hadongz/CFBoard/CFBoard.kicad_pcb

## KiCad design CFBoard.kicad_pcb (2025-09-06)

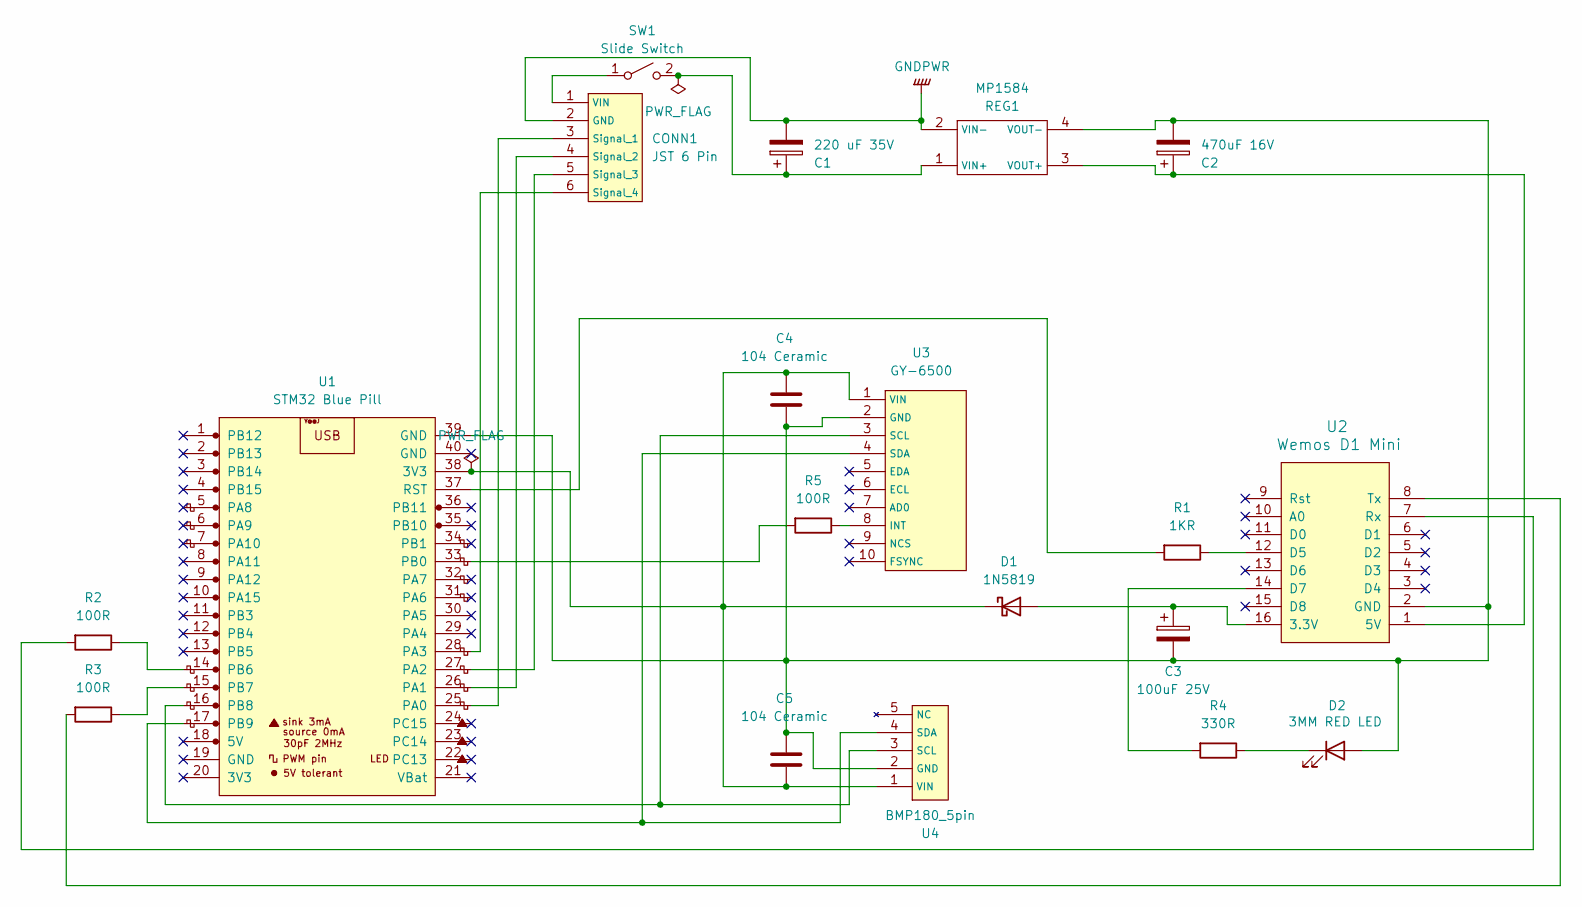
[picture p1: schematic CFBoard.kicad_sch]

Parts:
C1: 220 uF 35V; CP_Radial_D6.3mm_P2.50mm
C2: 470uF 16V; CP_Radial_D5.0mm_P2.50mm
C3: 100uF 25V; CP_Radial_D5.0mm_P2.50mm
C4, C5: 104 Ceramic; C_Disc_D4.3mm_W1.9mm_P5.00mm
CONN1: JST 6 Pin; JST_XH_B6B-XH-A_1x06_P2.50mm_Vertical
D1: 1N5819; D_DO-41_SOD81_P10.16mm_Horizontal
D2: 3MM RED LED; LED_D3.0mm
R1: 1KR; R_Axial_DIN0207_L6.3mm_D2.5mm_P7.62mm_Horizontal
R2, R3, R5: 100R; R_Axial_DIN0207_L6.3mm_D2.5mm_P7.62mm_Horizontal
R4: 330R; R_Axial_DIN0207_L6.3mm_D2.5mm_P7.62mm_Horizontal
REG1: MP1584
SW1: Slide Switch; SW_Slide-03_Wuerth-WS-SLTV_10x2.5x6.4_P2.54mm
U1: STM32 Blue Pill; YAAJ_BluePill_2
U2: Wemos D1 Mini; D1_mini_board
U3: GY-6500; GY6500
U4: BMP180_5pin; BMP180_5Pin

Connections:
GNDPWR: C1.2, CONN1.2 (GND), REG1.2 (VIN-)
unnamed: CONN1.3 (Signal_1), U1.25 (PA0)
unnamed: CONN1.4 (Signal_2), U1.26 (PA1)
unnamed: CONN1.5 (Signal_3), U1.27 (PA2)
unnamed: CONN1.6 (Signal_4), U1.28 (PA3)
unnamed: CONN1.1 (VIN), SW1.1 (A)
unnamed: C3.1, D1.2 (A), U2.16 (3.3V)
unnamed: C4.1, C5.2, D1.1 (K), U1.38 (3V3), U3.1 (VIN), U4.1 (VIN)
unnamed: C2.2, C3.2, C4.2, C5.1, D2.2 (A), REG1.4 (VOUT-), U1.39 (GND), U2.2 (GND), U3.2 (GND), U4.2 (GND)
unnamed: D2.1 (K), R4.1
unnamed: C1.1, REG1.1 (VIN+), SW1.2 (B)
unnamed: C2.1, REG1.3 (VOUT+), U2.1 (5V)
unnamed: R5.2, U1.33 (PB0)
unnamed: R2.1, U1.14 (PB6)
unnamed: R3.1, U1.15 (PB7)
unnamed: U1.16 (PB8), U3.3 (SCL), U4.3 (SCL)
unnamed: U1.17 (PB9), U3.4 (SDA), U4.4 (SDA)
unnamed: R1.2, U1.37 (RST)
unnamed: R1.1, U2.12 (D5)
unnamed: R4.2, U2.14 (D7)
unnamed: R2.2, U2.7 (Rx)
unnamed: R3.2, U2.8 (Tx)
unnamed: R5.1, U3.8 (INT)

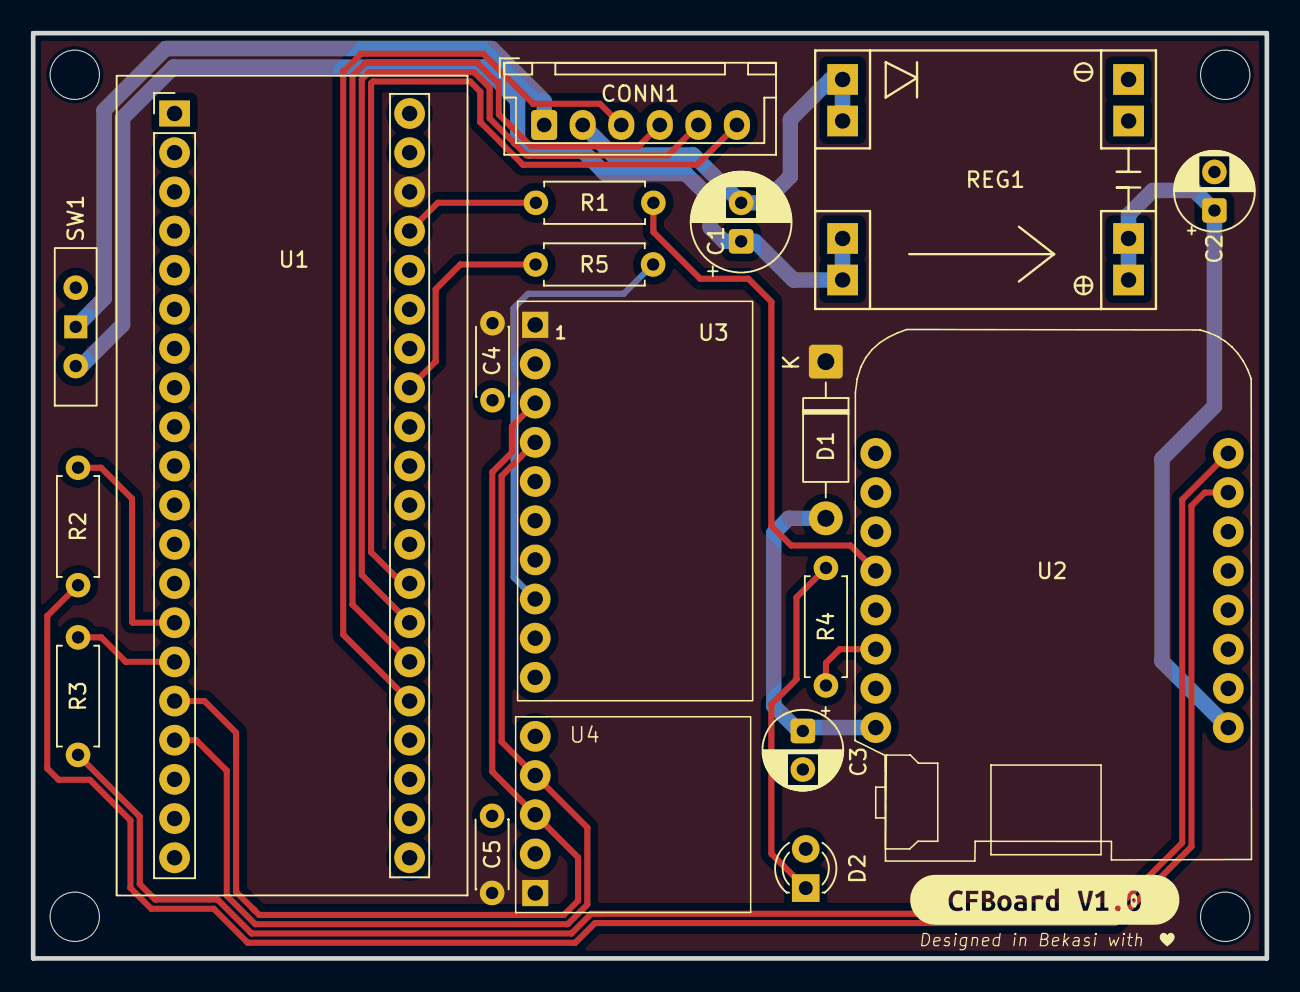
[picture p2: board CFBoard.kicad_pcb from above]

Board: 2 copper layers, 80.0 x 60.0 mm, 20 parts (0 on the bottom side), 23 nets.

Other parts of the board:
kibuzzard-689068BD: G***; kibuzzard-689068BD
