hadongz/CFBoard/(commit log)

2025-07-09 [initial commit]
    [CFBoard.kicad_pcb, CFBoard.kicad_sch]
2025-07-11 feat: layout all the components
    [CFBoard.kicad_sch]
2025-07-11 feat: pcb layout
    [CFBoard.kicad_pcb, CFBoard.kicad_sch]
2025-07-11 feat: wrap up version 1
    [CFBoard-B_Cu.gbr, CFBoard-B_Mask.gbr, CFBoard-B_Paste.gbr, CFBoard-B_Silkscreen.gbr, CFBoard-Edge_Cuts.gbr, CFBoard-F_Cu.gbr, CFBoard-F_Mask.gbr, CFBoard-F_Paste.gbr]
2025-07-12 chore: fix trace
    [CFBoard-B_Cu.gbr, CFBoard-B_Mask.gbr, CFBoard-B_Paste.gbr, CFBoard-B_Silkscreen.gbr, CFBoard-Edge_Cuts.gbr, CFBoard-F_Cu.gbr, CFBoard-F_Mask.gbr, CFBoard-F_Paste.gbr]
2025-07-17 feat: add silkscreen name and re-trace
    [CFBoard.kicad_pcb, CFBoard.kicad_sch]
2025-07-17 feat: generate gerbers
    [CFBoard-B_Cu.gbr, CFBoard-B_Mask.gbr, CFBoard-B_Paste.gbr, CFBoard-B_Silkscreen.gbr, CFBoard-Edge_Cuts.gbr, CFBoard-F_Cu.gbr, CFBoard-F_Mask.gbr, CFBoard-F_Paste.gbr]
2025-07-21 feat: update design
    [CFBoard-B_Cu.gbr, CFBoard-B_Mask.gbr, CFBoard-B_Paste.gbr, CFBoard-B_Silkscreen.gbr, CFBoard-Edge_Cuts.gbr, CFBoard-F_Cu.gbr, CFBoard-F_Mask.gbr, CFBoard-F_Paste.gbr]
2025-08-04 feat: update jst connector footprint design
    [CFBoard-B_Cu.gbr, CFBoard-B_Mask.gbr, CFBoard-B_Paste.gbr, CFBoard-B_Silkscreen.gbr, CFBoard-Edge_Cuts.gbr, CFBoard-F_Cu.gbr, CFBoard-F_Mask.gbr, CFBoard-F_Paste.gbr]
